BrianOn99/dokidoki/Sketch.png

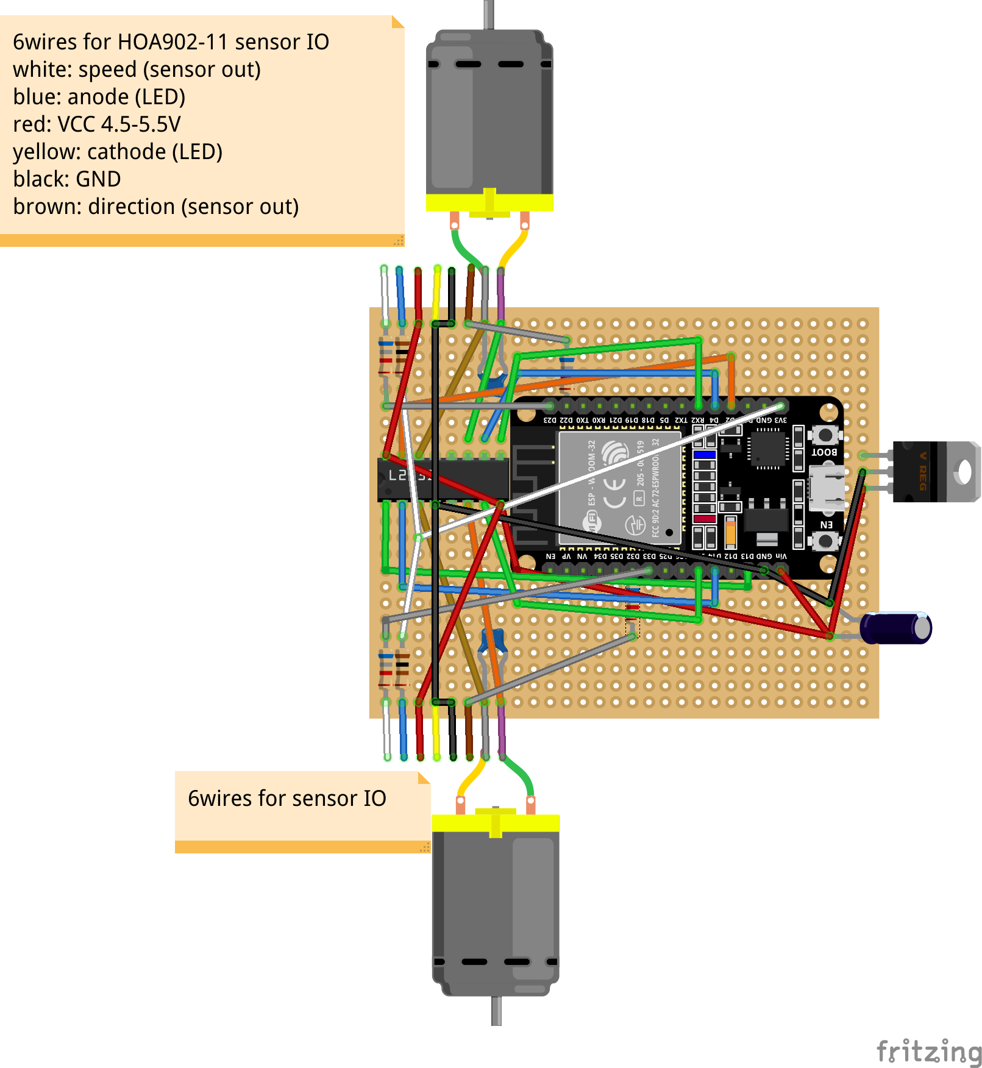
Sketch.png
