BrianOn99/dokidoki/(list of files, drawings)

Other design files:
Sketch.fzz
