BrianOn99/dokidoki/esp32/main/bluetooth.c

#include <stdint.h>
#include <stdbool.h>
#include <stdio.h>
#include "nvs.h"
#include "nvs_flash.h"
#include "freertos/FreeRTOS.h"
#include "freertos/task.h"
#include "esp_log.h"
#include "esp_bt.h"
#include "esp_bt_main.h"
#include "esp_gap_bt_api.h"
#include "esp_bt_device.h"
#include "esp_spp_api.h"

#define SPP_TAG "SPP"
#define SPP_SERVER_NAME "DOKIDOKI_SPP_SERVER"
#define DEVICE_NAME "DOKIDOKI"

static const esp_spp_mode_t esp_spp_mode = ESP_SPP_MODE_CB;
static const esp_spp_sec_t sec_mask = ESP_SPP_SEC_AUTHENTICATE;
static void (*command_handler)(esp_spp_cb_param_t *) = NULL;


static void esp_spp_cb(esp_spp_cb_event_t event, esp_spp_cb_param_t *param) {
	switch (event) {
		case ESP_SPP_INIT_EVT:
			ESP_LOGI(SPP_TAG, "ESP_SPP_INIT_EVT");
			esp_bt_dev_set_device_name(DEVICE_NAME);
			esp_bt_gap_set_scan_mode(ESP_BT_CONNECTABLE, ESP_BT_GENERAL_DISCOVERABLE);
			esp_spp_start_srv(sec_mask, ESP_SPP_ROLE_SLAVE, 0, SPP_SERVER_NAME);
			break;
		case ESP_SPP_DATA_IND_EVT:
			ESP_LOGI(SPP_TAG, "ESP_SPP_DATA_IND_EVT len=%d handle=%d",
					param->data_ind.len, param->data_ind.handle);
			esp_log_buffer_hex("",param->data_ind.data,param->data_ind.len);
			command_handler(param);
			break;
		default:
			ESP_LOGI(SPP_TAG, "SPP event: %d", event);
			break;
	}
}

void esp_bt_gap_cb(esp_bt_gap_cb_event_t event, esp_bt_gap_cb_param_t *param) {
	switch (event) {
		case ESP_BT_GAP_AUTH_CMPL_EVT:
			if (param->auth_cmpl.stat == ESP_BT_STATUS_SUCCESS) {
				ESP_LOGI(SPP_TAG, "authentication success: %s", param->auth_cmpl.device_name);
				esp_log_buffer_hex(SPP_TAG, param->auth_cmpl.bda, ESP_BD_ADDR_LEN);
			} else {
				ESP_LOGE(SPP_TAG, "authentication failed, status:%d", param->auth_cmpl.stat);
			}
			break;

#if (CONFIG_BT_SSP_ENABLED == true)
		case ESP_BT_GAP_CFM_REQ_EVT:
			ESP_LOGI(SPP_TAG, "ESP_BT_GAP_CFM_REQ_EVT Please compare the numeric value: %d", param->cfm_req.num_val);
			esp_bt_gap_ssp_confirm_reply(param->cfm_req.bda, true);
			break;
		case ESP_BT_GAP_KEY_NOTIF_EVT:
			ESP_LOGI(SPP_TAG, "ESP_BT_GAP_KEY_NOTIF_EVT passkey:%d", param->key_notif.passkey);
			break;
		case ESP_BT_GAP_KEY_REQ_EVT:
			ESP_LOGI(SPP_TAG, "ESP_BT_GAP_KEY_REQ_EVT Please enter passkey!");
			break;
#endif

		default:
			ESP_LOGI(SPP_TAG, "GAP event: %d", event);
			break;
	}
	return;
}

void bluetooth_init(void (*ch)(esp_spp_cb_param_t *)) {
	command_handler = ch;

	esp_err_t ret = nvs_flash_init();
	if (ret == ESP_ERR_NVS_NO_FREE_PAGES || ret == ESP_ERR_NVS_NEW_VERSION_FOUND) {
		ESP_ERROR_CHECK(nvs_flash_erase());
		ret = nvs_flash_init();
	}
	ESP_ERROR_CHECK( ret );

	ESP_ERROR_CHECK(esp_bt_controller_mem_release(ESP_BT_MODE_BLE));

	esp_bt_controller_config_t bt_cfg = BT_CONTROLLER_INIT_CONFIG_DEFAULT();
	if ((ret = esp_bt_controller_init(&bt_cfg)) != ESP_OK) {
		ESP_LOGE(SPP_TAG, "%s initialize controller failed: %s\n", __func__, esp_err_to_name(ret));
		return;
	}

	if ((ret = esp_bt_controller_enable(ESP_BT_MODE_CLASSIC_BT)) != ESP_OK) {
		ESP_LOGE(SPP_TAG, "%s enable controller failed: %s\n", __func__, esp_err_to_name(ret));
		return;
	}

	if ((ret = esp_bluedroid_init()) != ESP_OK) {
		ESP_LOGE(SPP_TAG, "%s initialize bluedroid failed: %s\n", __func__, esp_err_to_name(ret));
		return;
	}

	if ((ret = esp_bluedroid_enable()) != ESP_OK) {
		ESP_LOGE(SPP_TAG, "%s enable bluedroid failed: %s\n", __func__, esp_err_to_name(ret));
		return;
	}

	if ((ret = esp_bt_gap_register_callback(esp_bt_gap_cb)) != ESP_OK) {
		ESP_LOGE(SPP_TAG, "%s gap register failed: %s\n", __func__, esp_err_to_name(ret));
		return;
	}

	if ((ret = esp_spp_register_callback(esp_spp_cb)) != ESP_OK) {
		ESP_LOGE(SPP_TAG, "%s spp register failed: %s\n", __func__, esp_err_to_name(ret));
		return;
	}

	if ((ret = esp_spp_init(esp_spp_mode)) != ESP_OK) {
		ESP_LOGE(SPP_TAG, "%s spp init failed: %s\n", __func__, esp_err_to_name(ret));
		return;
	}

#if (CONFIG_BT_SSP_ENABLED == true)
	/* Set default parameters for Secure Simple Pairing */
	esp_bt_sp_param_t param_type = ESP_BT_SP_IOCAP_MODE;
	esp_bt_io_cap_t iocap = ESP_BT_IO_CAP_IO;
	esp_bt_gap_set_security_param(param_type, &iocap, sizeof(uint8_t));
#endif
}
