BrianOn99/dokidoki/(commit log)

2022-07-02 Control 1 motor by bluetooth
2022-07-02 Android app for bluetooth control
    [Sketch.fzz]
2022-07-03 Control direction
    [Sketch.fzz]
2022-07-09 Two motors
2022-07-15 Change pin number
2022-08-22 Update circuit
    [Sketch.fzz]
2022-09-04 Fix rotation direction and poor startup connection
    [dokidoki.c]
2022-10-30 Basic rotory sensor feedback control
    Rotate almost exact 2PI. Should exceed a little bit because of rotation
    inertia.
2022-10-31 handle all rotation sensors
2022-11-20 Correct GOTO rotation direction
    [dokidoki.c, takidoki.c]
2022-12-27 correct gear ratio
2023-05-01 Update hint and wiring
    [Sketch.fzz]
2023-11-18 Fix random rotation signal
    The pins 36 39 were not pulled down, making random signals. From:
    https://forum.arduino.cc/t/esp32-analog-read-pin-33-affects-interrupt-on-pin-36/1135342/9
    ```
    GPIOs 34 to 39 are GPIs – input only pins. These pins don’t have internal pull-up or pull-down resistors.
    ```
    [Sketch.fzz]
2023-11-26 star tracking
    2 tracking mode: manual and auto. Auto tracking is not tested yet.
    The PWM frequency is now set very low 4Hz. High frequency cannnot drive
    the motor the order of < 1 rotation per second.
2023-12-03 Bug fix rotation speed
    1. Incorrect rotation speed (android side)
    2. Unexpected back rotation when rotation speed change to 0. (maybe
    l293d issue). Work around: keep the rotation pin unchanged.
    [dokidoki.c]
